aotta/PicoBBCBC/(list of files, drawings)

Other design files:
PCB/PicoBBCBridge.dsn
