aotta/PicoBBCBC/PCB/PicoBBCBridge.kicad_pcb

## KiCad design PCB/PicoBBCBridge.kicad_pcb (2026-10-17)

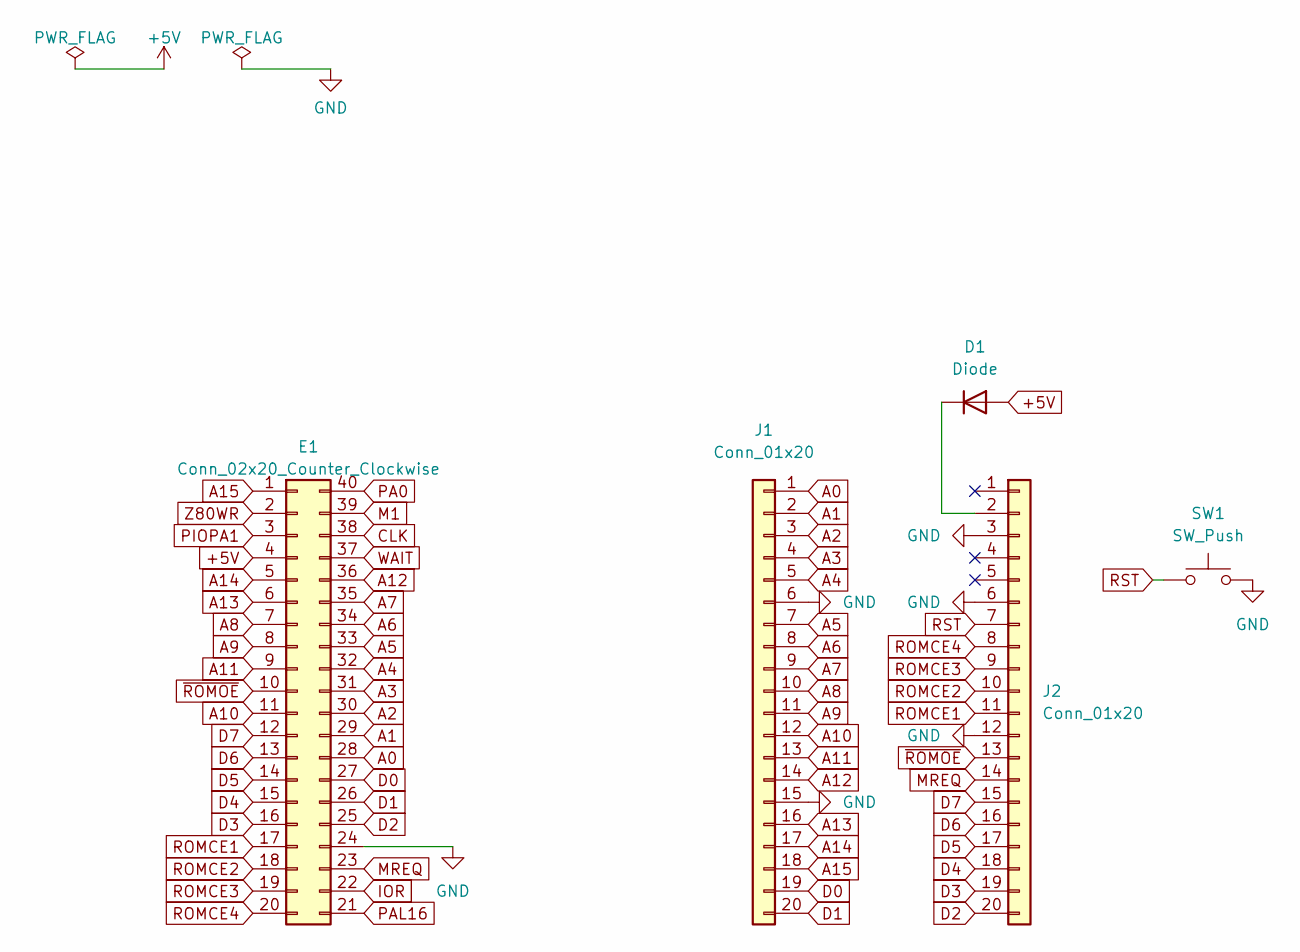
[picture p7: schematic PicoBBCBridge.kicad_sch, SD-1000 Multicart]

Parts:
D1: Diode; D_DO-35_SOD27_P7.62mm_Horizontal
E1: Conn_02x20_Counter_Clockwise; BBC_Bridge_Companion_Edge_40Pin
J1, J2: Conn_01x20; PinSocket_1x20_P2.54mm_Vertical
SW1: SW_Push; SW_PUSH_6mm

Connections:
+5V: D1.2 (A), E1.4
A0: E1.28, J1.1
A1: E1.29, J1.2
A2: E1.30, J1.3
A3: E1.31, J1.4
A4: E1.32, J1.5
A5: E1.33, J1.7
A6: E1.34, J1.8
A7: E1.35, J1.9
A8: E1.7, J1.10
A9: E1.8, J1.11
A10: E1.11, J1.12
A11: E1.9, J1.13
A12: E1.36, J1.14
A13: E1.6, J1.16
A14: E1.5, J1.17
A15: E1.1, J1.18
CLK: E1.38
D0: E1.27, J1.19
D1: E1.26, J1.20
D2: E1.25, J2.20
D3: E1.16, J2.19
D4: E1.15, J2.18
D5: E1.14, J2.17
D6: E1.13, J2.16
D7: E1.12, J2.15
GND: E1.24, J1.6, J1.15, J2.3, J2.6, J2.12, SW1.2
IOR: E1.22
M1: E1.39
MREQ: E1.23, J2.14
unnamed: D1.1 (K), J2.2
PA0: E1.40
PAL16: E1.21
PIOPA1: E1.3
ROMCE1: E1.17, J2.11
ROMCE2: E1.18, J2.10
ROMCE3: E1.19, J2.9
ROMCE4: E1.20, J2.8
RST: J2.7, SW1.1
WAIT: E1.37
Z80WR: E1.2
~ROMOE: E1.10, J2.13

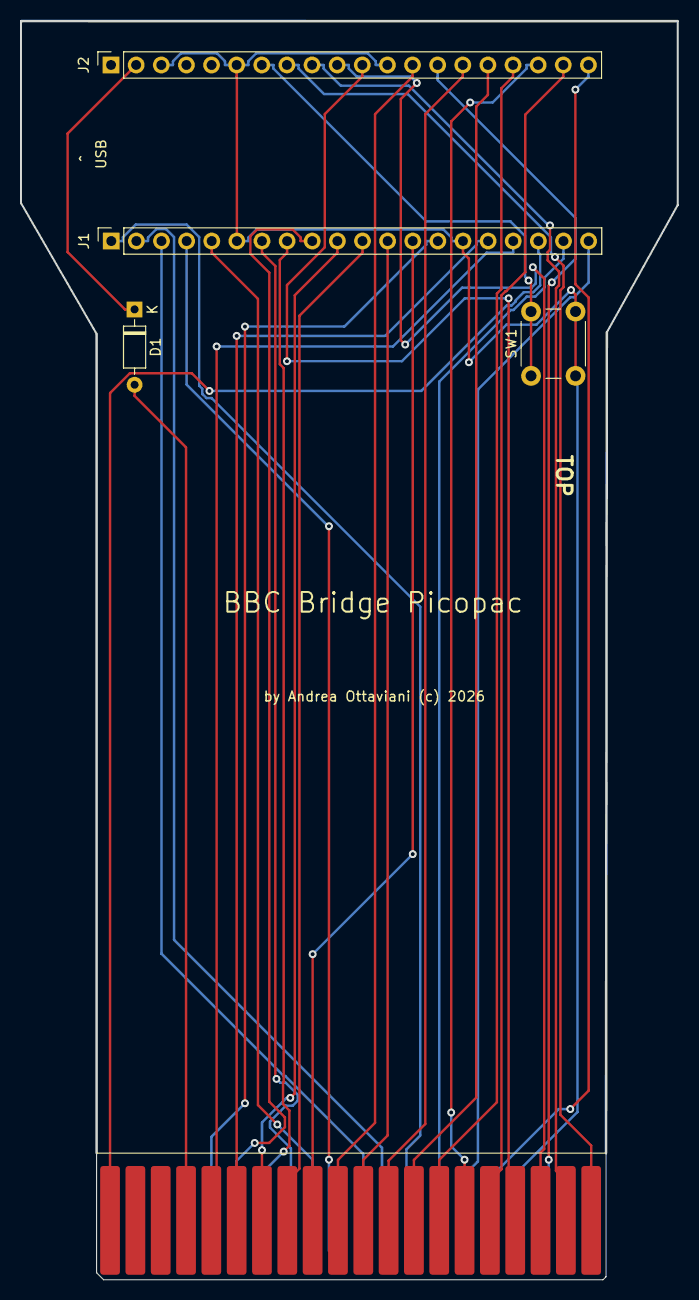
[picture p8: board PicoBBCBridge.kicad_pcb from above]

Board: 2 copper layers, 66.4 x 127.3 mm, 5 parts (0 on the bottom side), 34 nets.
