aotta/PicoBBCBC/(commit log)

2026-10-17 Replace PCB image and add additional images
    Updated images in the README for the multicart PCB and assembly.
2026-10-17 Revise Pico firmware installation steps
    Updated instructions for flashing and using Pico firmware.
