aotta/PicoBBCBC/(notices)

Notices in the files:
PCB/PicoBBCBridge.kicad_pcb:
by Andrea Ottaviani (c) 2026
